qqqqya/init-Tacglove/Docs/03_第一阶段移植与验证.md

# 03 第一阶段移植与验证

> 历史说明：本文记录阶段1当时的实现。按键到LED反馈现已改为FreeRTOS Task Notification，当前链路以 `10_按键任务通知_软件接口与Agent日志说明.md`为准。

## 1. 本次已完成内容

- 从最终样板工程移植完整 FreeRTOS V11.1.0 源码目录。
- 使用 GCC Cortex-M4F port 和 heap_4，FreeRTOS heap 为 25 KB。
- 由 FreeRTOS 直接提供 SVC、PendSV 和 SysTick 异常处理。
- 新增 LED Driver/Handler、KEY Handler及单文件BEEP Driver。
- 新增 `led_task`、`key_task` 和任务管理器，共两个业务任务。
- 按键任务识别事件后直接调用LED任务动作接口，不使用FreeRTOS任务通知。
- 两个任务均由 `task_manager_init()` 直接调用 `xTaskCreate()` 创建。
- `main()` 完成任务创建后启动调度器。
- CMake构建后生成 ELF、HEX 和 BIN 三种固件文件。

## 2. `.ioc` 与生成代码同步修改

用户已完成：

- PA11 改为上拉输入。
- PB0 改为 Very High 输出速度。
- USART1关闭。
- USART2 RX改为循环DMA，TX为普通DMA，RX/TX均为High DMA优先级。

本次继续修改：

- 暂时移除 IWDG，避免尚未建立健康监控时约2秒复位。
- 暂时移除 TIM3，按键由1 ms FreeRTOS任务推进状态机，不再需要定时器中断。
- USART2、DMA1 Channel2/3 NVIC优先级统一调整为6，允许未来安全使用 FreeRTOS FromISR API。
- 保留 TIM1 作为 HAL 1 ms时间基准，FreeRTOS使用SysTick。

## 3. SK6805驱动说明

旧驱动依赖 STM32F042 48 MHz 下的固定 NOP 数量，不能直接运行在170 MHz STM32G474上。新驱动仍采用 PB0 GPIO单线协议，但使用 Cortex-M4 DWT周期计数。刷新接口统一命名为 `bsp_led_driver_commit()`，并按代码规范取消函数级 `optimize("O2")` 属性：

| 参数 | 软件目标值 | 170 MHz目标周期 |
|---|---:|---:|
| T0H | 0.3 us | 51 cycles |
| T1H | 0.9 us | 153 cycles |
| 单bit周期 | 1.2 us | 204 cycles |
| Reset低电平 | 300 us | 51000 cycles |

发送一帧时关闭中断约 `6 × 24 × 1.2 us = 172.8 us`。数据发送结束后立即恢复中断，Reset低电平阶段允许任务和中断运行。

## 4. 上板预期现象

1. LED2-LED6绿色闪烁3次，LED7始终熄灭。
2. LED2-LED6绿色常亮，进入待机。
3. 待机单击：LED7蓝闪3次，蜂鸣器短鸣120 ms，LED7蓝色常亮。
4. 采集中再次单击：蜂鸣器短鸣120 ms，LED7熄灭，返回绿色待机。
5. 长按和双击执行临时识别反馈，结束后恢复原主状态。

## 5. 逻辑分析仪检查

测量 PB0，建议采样率不低于 50 MHz，优先使用 100 MHz或更高：

- 逻辑0高电平应约0.3 us，且不超过0.4 us。
- 逻辑1高电平应约0.9 us，且不低于0.7 us。
- 单bit周期目标约1.2 us。
- 每帧结束低电平应不小于200 us，当前目标300 us。
- 检查完整帧包含 `6 × 24 = 144 bit`。

由于实际脉宽会受到编译器、Flash等待和寄存器访问开销影响，逻辑分析仪实测值是最终依据。如不合格，只调整 `bsp_led_driver.c` 中的时序常量，不改Handler和任务层。用户已确认首轮上板的灯效、按键和蜂鸣器现象均正确。

## 6. 当前边界

- 尚未上板烧录，本次完成的是源码移植和编译验证。
- 尚未加入 micro-ROS。
- 尚未实现相机 READY/RUNNING/STOPPED/FAULT 联动。
- IWDG 和 TIM3 当前明确停用，后续启用时必须同时修改 `.ioc`、生成代码和本目录文档。

## 7. 编译验证结果

2026-09-11 使用 GCC 15.2.1 完成 Debug 和 Release 构建，均无错误、无警告。

| 配置 | Flash | RAM |
|---|---:|---:|
| Debug | 28708 bytes | 27984 bytes |
| Release | 16836 bytes | 27984 bytes |

构建目录中已生成 `glove_UMI_APP.elf`、`glove_UMI_APP.hex` 和 `glove_UMI_APP.bin`。符号检查确认 SVC、PendSV、SysTick 均由 FreeRTOS Cortex-M4F port 提供。
