qqqqya/init-Tacglove/Docs/04_编码规范化修改记录.md

# 04 编码规范化修改记录

> 历史说明：本文记录当时的规范化结果。按键到LED反馈现已改为FreeRTOS Task Notification，当前规范和链路分别以 `C_CODE_STYLE_GUIDE.md`、`10_按键任务通知_软件接口与Agent日志说明.md`为准。

## 1. 修改目的

首轮灯、按键和蜂鸣器上板现象已经确认正确。本次不改变灯效和按键业务逻辑，只统一新增代码的命名、分层状态、主要函数注释和模块边界，为后续USART2与micro-ROS移植建立一致基线。

## 2. LED修改

- 物理帧发送接口由 `bsp_led_driver_show()` 更名为 `bsp_led_driver_commit()`；
- `bsp_led_handler_commit()`同步调用新的Driver接口；
- 删除 `#if defined(__GNUC__)` 和函数级 `__attribute__((optimize("O2")))`；
- DWT周期计数时序方案保持不变，仍按 `SystemCoreClock` 换算T0H、T1H、bit周期和reset周期；
- LED Driver使用 `led_driver_status_t`；
- LED Handler使用 `led_handler_status_t`，通过静态转换函数映射Driver错误，不再直接透传底层状态；
- 公开函数和时序关键静态函数补充Doxygen注释，写明参数范围、单位、返回值、中断影响和逻辑分析仪复测要求；
- 数据顺序保持为LED7、LED6、LED5、LED4、LED3、LED2；业务映射更新为相机1~5对应LED2~LED6，鱼眼不设指示灯，LED7为系统状态灯。

取消函数级优化属性后，Debug和Release均可编译，但生成指令会变化。因此下次烧录后需要重新测量两种构建的PB0波形，不能直接沿用修改前的时序结论。

## 3. 蜂鸣器修改

- 删除 `bsp_beep_handler.c/.h`；
- CMake移除蜂鸣器Handler源码；
- 只保留 `bsp_beep_driver.c/.h`这一组Driver文件；
- Driver继续只负责PB9低电平有效和安全初始电平；
- 120 ms鸣叫时长仍由指示任务控制，Driver中不使用FreeRTOS延时；
- 返回状态改为独立的 `beep_driver_status_t`。

这里的“单一Driver文件”按C工程常规表示一个模块的 `.c + .h` 文件对，不再拆成Driver层和Handler层两个模块。

## 4. 同批新增代码规范化

- KEY Handler改为独立 `key_handler_status_t`；
- 删除未到开发时机的Application事件队列；
- `indicator_task`改为职责明确的 `led_task`；
- 当前只有 `led_task` 和 `key_task` 两个任务；按键事件直接调用LED任务动作接口，不使用FreeRTOS任务通知；
- 两个 `xTaskCreate()` 直接写在 `task_manager_init()`，并逐项检查创建结果；
- BSP和Tasks的公开接口及主要静态函数补充文件头和Doxygen注释；
- 状态比较统一采用常量在左侧的写法。

已删除不再使用的公共 `BSP/bsp_status.h`，避免后续代码继续混用旧的通用状态类型。

## 5. 配置影响

本次没有改变引脚、时钟、DMA或NVIC配置，因此 `.ioc` 不需要修改。后续任何外设配置变化仍必须同步修改 `.ioc`、生成代码和对应验证文档。

## 6. 构建验证

2026-09-09重新完成Debug和Release构建，均无错误、无警告，并重新生成ELF、HEX和BIN。

| 配置 | Flash | RAM |
|---|---:|---:|
| Debug | 28160 bytes | 27952 bytes |
| Release | 16704 bytes | 27952 bytes |

## 7. 下次上板复测

1. 烧录新的Release固件，确认绿色自检、绿色待机、LED7蓝闪/蓝常亮和蜂鸣器动作；
2. 测量Release下T0H、T1H、bit周期和reset低电平；
3. 烧录Debug固件重复测量；
4. 将两组实测值补充到第一阶段验证记录；
5. 两种构建均通过后，关闭阶段1并进入阶段2稳定化测试。
