qqqqya/init-Tacglove/Firmware/SCH_Schematic1_五指数采2026-09-09.pdf

# 1-7HUB

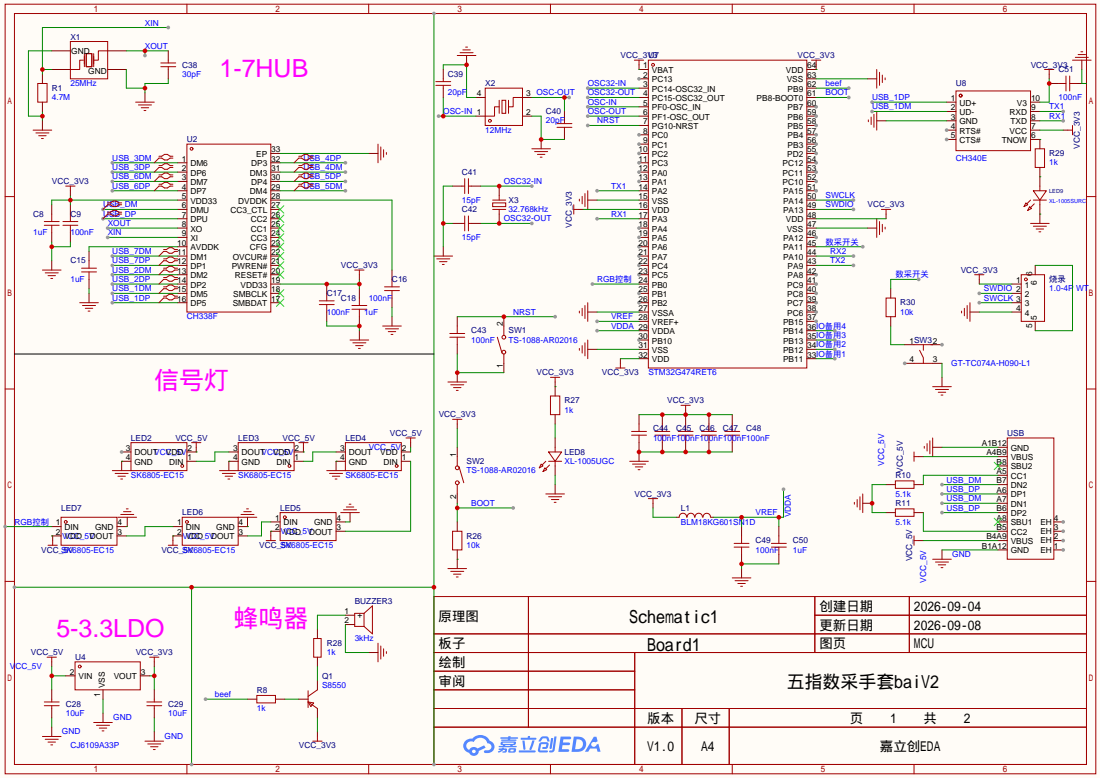
[picture p1: page 1]

板子 | Board1 | 图页 | MCU
绘制 | | 五指数采手套baiV2
审阅

V1.0 | A4 | 嘉立创EDA

鱼眼

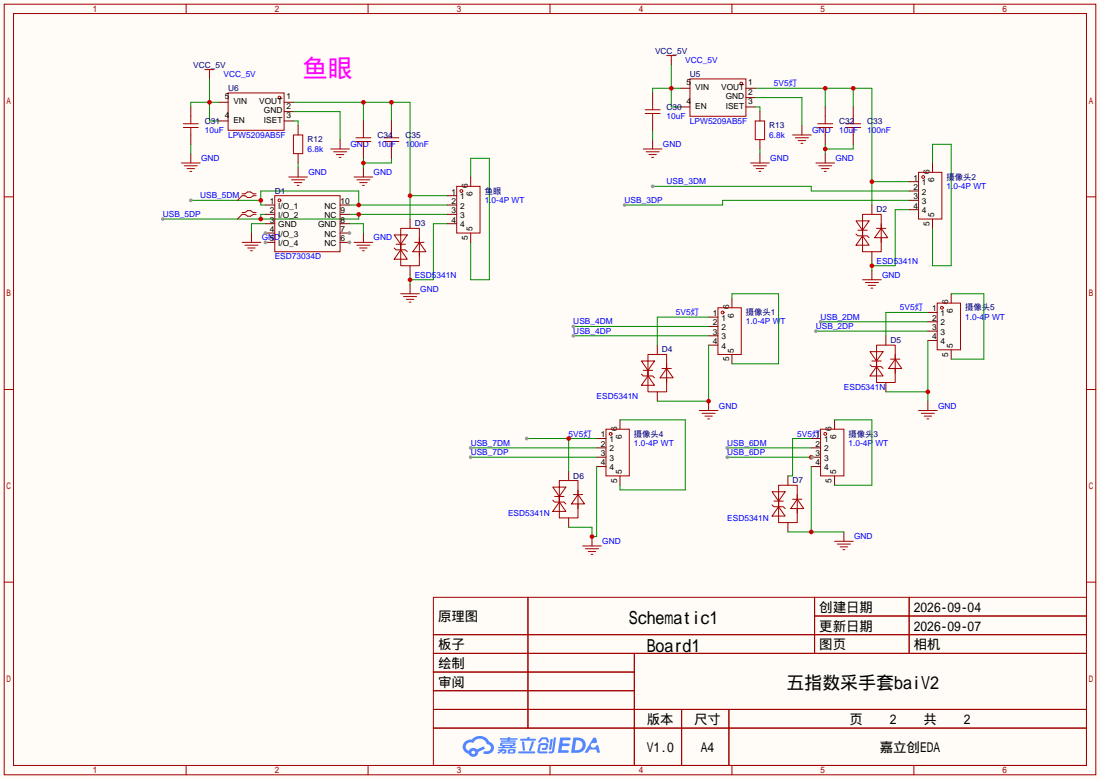
[picture p2: page 2]

原理图 | Schematic1 | 创建日期 | 2026-09-04

更新日期 | 2026-09-07

板子 | Board1 | 图页 | 相机
绘制 | | 五指数采手套baiV2
审阅

V1.0 | A4 | 嘉立创EDA
