qqqqya/init-Tacglove/Application/glove_UMI_APP.ioc

Mcu.UserName=STM32G474RETx
PA11.GPIO_Label=key_cap
PA11.Signal=GPIO_Input
PA13.Signal=SYS_JTMS-SWDIO
PA14.Signal=SYS_JTCK-SWCLK
PA2.Signal=USART2_TX
PA3.Signal=USART2_RX
PB0.GPIO_Label=rgb_ctrl
PB0.Signal=S_TIM3_CH3
PB9.GPIO_Label=beep
PB9.Signal=GPIO_Output
PC14-OSC32_IN.Signal=RCC_OSC32_IN
PC15-OSC32_OUT.Signal=RCC_OSC32_OUT
PF0-OSC_IN.Signal=RCC_OSC_IN
PF1-OSC_OUT.Signal=RCC_OSC_OUT
