qqqqya/init-Tacglove/Application/Core/Inc/main.h

#define key_cap_Pin GPIO_PIN_11
#define key_cap_GPIO_Port GPIOA
#define rgb_ctrl_Pin GPIO_PIN_0
#define rgb_ctrl_GPIO_Port GPIOB
#define beep_Pin GPIO_PIN_9
#define beep_GPIO_Port GPIOB
