qqqqya/init-Tacglove/Bootloader/Core/Inc/gpio.h

/**
 * @file gpio.h
 * @brief Bootloader GPIO初始化接口。
 */
#ifndef GPIO_H
#define GPIO_H

#ifdef __cplusplus
extern "C" {
#endif

void MX_GPIO_Init(void);

#ifdef __cplusplus
}
#endif

#endif /* GPIO_H */
